uvmaero/SEED/BMS1/report.txt

Info: Processing symbol 'B1:AERO_Footprints:VTC-6'.
Info: Processing symbol 'B2:AERO_Footprints:VTC-6'.
Info: Processing symbol 'B3:AERO_Footprints:VTC-6'.
Info: Processing symbol 'B4:AERO_Footprints:VTC-6'.
Info: Processing symbol 'B5:AERO_Footprints:VTC-6'.
Info: Processing symbol 'B6:AERO_Footprints:VTC-6'.
Info: Processing symbol 'C24:Capacitor_SMD:C_0603_1608Metric_Pad1.08x0.95mm_HandSolder'.
Info: Processing symbol 'C40:'.
Info: Processing symbol 'B7:AERO_Footprints:VTC-6'.
Info: Processing symbol 'R36:Resistor_SMD:R_2512_6332Metric_Pad1.40x3.35mm_HandSolder'.
Info: Processing symbol 'C5:Capacitor_SMD:C_0603_1608Metric_Pad1.08x0.95mm_HandSolder'.
Info: Processing symbol 'C41:Capacitor_SMD:C_0603_1608Metric_Pad1.08x0.95mm_HandSolder'.
Info: Processing symbol 'C25:Capacitor_SMD:C_0603_1608Metric_Pad1.08x0.95mm_HandSolder'.
Info: Processing symbol 'B8:AERO_Footprints:VTC-6'.
Info: Processing symbol 'R33:Resistor_SMD:R_2512_6332Metric_Pad1.40x3.35mm_HandSolder'.
Info: Processing symbol 'J3:Connector_JST:JST_XH_B2B-XH-A_1x02_P2.50mm_Vertical'.
Info: Processing symbol 'C6:Capacitor_SMD:C_0603_1608Metric_Pad1.08x0.95mm_HandSolder'.
Info: Processing symbol 'R11:Resistor_SMD:R_0603_1608Metric_Pad0.98x0.95mm_HandSolder'.
Info: Processing symbol 'B9:AERO_Footprints:VTC-6'.
Info: Processing symbol 'C26:Capacitor_SMD:C_0603_1608Metric_Pad1.08x0.95mm_HandSolder'.
Info: Processing symbol 'R4:Resistor_SMD:R_0603_1608Metric_Pad0.98x0.95mm_HandSolder'.
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
Changed C28 value from 15u to .1u.
Updated C28 fields.
Updated C28 footprint filters to 'C_*'.
Changed C29 value from 15u to .1u.
Updated C29 fields.
Updated C29 footprint filters to 'C_*'.
Changed C30 value from 15u to .1u.
Updated C30 fields.
Updated C30 footprint filters to 'C_*'.
Changed C31 value from 15u to .1u.
Updated C31 fields.
Updated C31 footprint filters to 'C_*'.
Changed C32 value from 15u to .1u.
Updated C32 fields.
Updated C32 footprint filters to 'C_*'.
Changed C33 value from 15u to .1u.
Updated C33 fields.
Updated C33 footprint filters to 'C_*'.
Changed C34 value from 15u to .1u.
Updated C34 fields.
Updated C34 footprint filters to 'C_*'.
Changed C35 value from 15u to .1u.
Updated C35 fields.
Updated C35 footprint filters to 'C_*'.
Changed C36 value from 15u to 0.1u.
Updated C36 fields.
Updated C36 footprint filters to 'C_*'.
Changed C37 value from 15u to .1u.
Updated C37 fields.
Updated C37 footprint filters to 'C_*'.
Changed C38 value from 15u to .1u.
Updated C38 fields.
Updated C38 footprint filters to 'C_*'.
Changed C39 value from 15u to .1u.
Updated C39 fields.
Updated C39 footprint filters to 'C_*'.
Added C41 (footprint 'Capacitor_SMD:C_0603_1608Metric_Pad1.08x0.95mm_HandSolder').
Changed REF** reference designator to C41.
Changed C41 value from C_0603_1608Metric_Pad1.08x0.95mm_HandSolder to 1uf.
Updated C41 symbol association from  to /a6e080b4-c958-4e11-8509-e7d845006a0a.
Updated C41 sheetname to 'Root'.
Updated C41 sheetfile to 'BMS1.kicad_sch'.
Updated C41 footprint filters to 'C_*'.
Add net Net-(U9-VREF2).
Connected C41 pin 2 to Net-(U9-VREF2).
Connected C41 pin 1 to GND2.
Added C42 (footprint 'Capacitor_SMD:C_0603_1608Metric_Pad1.08x0.95mm_HandSolder').
Changed REF** reference designator to C42.
Changed C42 value from C_0603_1608Metric_Pad1.08x0.95mm_HandSolder to 1uf.
Updated C42 symbol association from  to /daf656fa-d1d1-4473-b492-9234140c10e1.
Updated C42 sheetname to 'Root'.
Updated C42 sheetfile to 'BMS1.kicad_sch'.
Updated C42 footprint filters to 'C_*'.
Connected C42 pin 2 to VD.
Connected C42 pin 1 to GND1.
Added C43 (footprint 'Capacitor_SMD:C_0603_1608Metric_Pad1.08x0.95mm_HandSolder').
Changed REF** reference designator to C43.
Changed C43 value from C_0603_1608Metric_Pad1.08x0.95mm_HandSolder to 1uf.
Updated C43 symbol association from  to /74a538cc-4349-4e3c-b11e-23ffc7b8507e.
Updated C43 sheetname to 'Root'.
Updated C43 sheetfile to 'BMS1.kicad_sch'.
Updated C43 footprint filters to 'C_*'.
Connected C43 pin 1 to GND2.
Connected C43 pin 2 to VDD.
Updated D1 fields.
Updated D1 sheetname to 'Root'.
Updated D1 footprint filters to 'LED* LED_SMD:* LED_THT:*'.
Updated D2 fields.
Updated D2 sheetname to 'Root'.
Updated D2 footprint filters to 'LED* LED_SMD:* LED_THT:*'.
Updated J1 fields.
Updated J1 sheetname to 'Root'.
Updated J1 footprint filters to 'Connector*:*_1x??_*'.
Updated J2 fields.
Updated J2 sheetname to 'Root'.
Updated J2 footprint filters to 'Connector*:*_1x??_*'.
Updated J3 fields.
Updated J3 sheetname to 'Root'.
Updated J3 footprint filters to 'Connector*:*_1x??_*'.
Added JP1 (footprint 'Jumper:SolderJumper-3_P1.3mm_Bridged12_RoundedPad1.0x1.5mm_NumberLabels').
Changed REF** reference designator to JP1.
Changed JP1 value from SolderJumper-3_P1.3mm_Bridged12_RoundedPad1.0x1.5mm_NumberLabels to Jumper_3_Bridged12.
Updated JP1 symbol association from  to /2f43baf8-2883-41e4-9e19-3010642f43dc.
Updated JP1 sheetname to 'Root'.
Updated JP1 sheetfile to 'BMS1.kicad_sch'.
Updated JP1 footprint filters to 'Jumper* TestPoint*3Pads* TestPoint*Bridge*'.
Removed JP1 'exclude from BOM' fabrication attribute.
Add net unconnected-(JP1-C-Pad2).
Connected JP1 pin 2 to unconnected-(JP1-C-Pad2).
Add net unconnected-(JP1-A-Pad1).
Connected JP1 pin 1 to unconnected-(JP1-A-Pad1).
Add net unconnected-(JP1-B-Pad3).
Connected JP1 pin 3 to unconnected-(JP1-B-Pad3).
Changed Q2 value from Q_NPN_BCE to DXT5551P5-13_DIO.
Updated Q2 fields.
Updated Q2 sheetname to 'Root'.
Reconnected Q2 pin 1 from Net-(Q2-B) to VCC.
Reconnected Q2 pin 2 from VCC to Net-(Q2-B).
Updated R1 fields.
Updated R1 sheetname to 'Root'.
Updated R1 footprint filters to 'R_*'.
Updated R2 fields.
Updated R2 sheetname to 'Root'.
Updated R2 footprint filters to 'R_*'.
Updated R3 sheetname to 'Root'.
Updated R3 footprint filters to 'R_*'.
Reconnected R3 pin 2 from /SCL2 to /SDA2.
Updated R4 fields.
Updated R4 sheetname to 'Root'.
Updated R4 footprint filters to 'R_*'.
Reconnected R4 pin 2 from /SDA2 to /SCL2.
Updated R5 fields.
Updated R5 sheetname to 'Root'.
Updated R5 footprint filters to 'R_*'.
Updated R6 fields.
Updated R6 sheetname to 'Root'.
Updated R6 footprint filters to 'R_*'.
Updated R7 fields.
Updated R7 sheetname to 'Root'.
Updated R7 footprint filters to 'R_*'.
Updated R8 fields.
Updated R8 sheetname to 'Root'.
Updated R8 footprint filters to 'R_*'.
Updated R9 fields.
Updated R9 sheetname to 'Root'.
Updated R9 footprint filters to 'R_*'.
Updated R10 fields.
Updated R10 sheetname to 'Root'.
Updated R10 footprint filters to 'R_*'.
Updated R11 fields.
Updated R11 sheetname to 'Root'.
Updated R11 footprint filters to 'R_*'.
Updated R12 fields.
Updated R12 sheetname to 'Root'.
Updated R12 footprint filters to 'R_*'.
Updated R13 fields.
Updated R13 footprint filters to 'R_*'.
Add net /BatteryBus1.C15.
Reconnected R13 pin 1 from /BatteryBus1.C14 to /BatteryBus1.C15.
Updated R14 fields.
Updated R14 footprint filters to 'R_*'.
Updated R15 fields.
Updated R15 footprint filters to 'R_*'.
Reconnected R15 pin 1 from Net-(B8--) to Net-(B9-+).
Updated R16 fields.
Updated R16 footprint filters to 'R_*'.
Reconnected R16 pin 1 from Net-(B11--) to Net-(B12-+).
Updated R17 fields.
Updated R17 footprint filters to 'R_*'.
Updated R18 fields.
Updated R18 footprint filters to 'R_*'.
Updated R19 fields.
Updated R19 footprint filters to 'R_*'.
Reconnected R19 pin 1 from Net-(B10--) to Net-(B11-+).
Updated R20 fields.
Updated R20 footprint filters to 'R_*'.
Updated R21 fields.
Updated R21 footprint filters to 'R_*'.
Reconnected R21 pin 1 from Net-(B7--) to Net-(B8-+).
Updated R22 fields.
Updated R22 footprint filters to 'R_*'.
Updated R23 fields.
Updated R23 footprint filters to 'R_*'.
Updated R24 fields.
Updated R24 footprint filters to 'R_*'.
Updated R25 fields.
Updated R25 footprint filters to 'R_*'.
Updated R26 fields.
Updated R26 footprint filters to 'R_*'.
Reconnected R26 pin 1 from Net-(B6--) to Net-(B7-+).
Updated R27 fields.
Updated R27 footprint filters to 'R_*'.
Updated R28 fields.
Updated R28 footprint filters to 'R_*'.
Reconnected R28 pin 1 from Net-(B8--) to Net-(B9-+).
Updated R29 fields.
Updated R29 footprint filters to 'R_*'.
Reconnected R29 pin 1 from Net-(B11--) to Net-(B12-+).
Updated R30 fields.
Updated R30 footprint filters to 'R_*'.
Updated R31 fields.
Updated R31 footprint filters to 'R_*'.
Reconnected R31 pin 1 from Net-(B7--) to Net-(B8-+).
Updated R32 fields.
Updated R32 footprint filters to 'R_*'.
Updated R33 fields.
Updated R33 footprint filters to 'R_*'.
Updated R3 fields.
Updated R34 fields.
Updated R34 footprint filters to 'R_*'.
Updated R35 fields.
Updated R35 footprint filters to 'R_*'.
Reconnected R35 pin 1 from Net-(B10--) to Net-(B11-+).
Updated R36 fields.
Updated R36 footprint filters to 'R_*'.
Add net unconnected-(B6---Pad2).
Updated R37 fields.
Updated R37 footprint filters to 'R_*'.
Reconnected B6 pin 2 from Net-(B6--) to unconnected-(B6---Pad2).
Updated R38 fields.
Updated R38 footprint filters to 'R_*'.
Reconnected R38 pin 1 from Net-(B6--) to Net-(B7-+).
Add net unconnected-(B7---Pad2).
Updated R39 fields.
Updated R39 footprint filters to 'R_*'.
Reconnected B7 pin 2 from Net-(B7--) to unconnected-(B7---Pad2).
Updated R40 fields.
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
Updated R95 fields.
Updated R95 sheetname to 'Root'.
Updated R95 footprint filters to 'R_*'.
Reconnected B22 pin 1 from Net-(B21--) to Net-(B22-+).
Add net unconnected-(B23---Pad2).
Reconnected B23 pin 2 from Net-(B23--) to unconnected-(B23---Pad2).
Updated T1 fields.
Updated T1 sheetname to 'Root'.
Updated T1 footprint filters to 'SOIC4_CBM4D19_SUM SOIC4_CBM4D19_SUM-M SOIC4_CBM4D19_SUM-L'.
Add net Net-(B23-+).
Updated U1 fields.
Updated U1 sheetname to 'Root'.
Updated U1 footprint filters to 'TSSOP*4.4x5mm*P0.65mm*'.
Reconnected B23 pin 1 from Net-(B22--) to Net-(B23-+).
Updated U2 fields.
Updated U2 sheetname to 'Root'.
Updated U2 footprint filters to 'TSSOP*4.4x5mm*P0.65mm*'.
Add net Net-(B24-+).
Updated U3 fields.
Updated U3 sheetname to 'Root'.
Updated U3 footprint filters to 'TSSOP*4.4x5mm*P0.65mm*'.
Reconnected B24 pin 1 from Net-(B23--) to Net-(B24-+).
Updated U4 fields.
Updated U4 sheetname to 'Root'.
Updated U4 footprint filters to 'TSSOP*4.4x5mm*P0.65mm*'.
Add net unconnected-(B24---Pad2).
Updated U5 fields.
Updated U5 sheetname to 'Root'.
Updated U5 footprint filters to 'TSSOP*4.4x5mm*P0.65mm*'.
Reconnected B24 pin 2 from Net-(B24--) to unconnected-(B24---Pad2).
Updated U6 fields.
Updated U6 sheetname to 'Root'.
Updated U6 footprint filters to 'TSSOP*4.4x5mm*P0.65mm*'.
Add net Net-(B25-+).
Updated U7 fields.
Updated U7 sheetname to 'Root'.
Updated U7 footprint filters to 'TSSOP*4.4x5mm*P0.65mm*'.
Reconnected B25 pin 1 from Net-(B24--) to Net-(B25-+).
Updated U8 fields.
Updated U8 sheetname to 'Root'.
Updated U8 footprint filters to 'TSSOP*4.4x5mm*P0.65mm*'.
Changed C1 value from 15u to 0.1uF.
Updated U9 sheetname to 'Root'.
Add net unconnected-(U9-GPIO3-Pad41).
Reconnected U9 pin 41 from /SCL2 to unconnected-(U9-GPIO3-Pad41).
Reconnected U9 pin 12 from Net-(U9-C11) to /BatteryBus1.C11.
Reconnected U9 pin 6 from /BatteryBus1.C14 to /BatteryBus1.C15.
Reconnected U9 pin 28 from Net-(U9-C5) to /BatteryBus1.C5.
Reconnected U9 pin 43 from unconnected-(U9-GPIO5-Pad43) to /SCL2.
Reconnected U9 pin 50 from unconnected-(U9-VREF2-Pad50) to Net-(U9-VREF2).
Reconnected U9 pin 8 from Net-(U9-C13) to /BatteryBus1.C15.
Reconnected U9 pin 38 from Net-(U9-C0) to /BatteryBus1.C0.
Add net Net-(Q3-B).
Reconnected U9 pin 49 from Net-(Q1-B) to Net-(Q3-B).
Reconnected U9 pin 20 from Net-(U9-C8) to /BatteryBus1.C8.
Reconnected U9 pin 24 from Net-(U9-C6) to /BatteryBus1.C6.
Reconnected U9 pin 34 from Net-(U9-C2) to /BatteryBus1.C2.
Reconnected U9 pin 30 from Net-(U9-C4) to /BatteryBus1.C4.
Reconnected U9 pin 10 from Net-(U9-C12) to /BatteryBus1.C12.
Reconnected U9 pin 4 from /BatteryBus1.C14 to /BatteryBus1.C15.
Reconnected U9 pin 22 from Net-(U9-C7) to /BatteryBus1.C7.
Reconnected U9 pin 32 from Net-(U9-C3) to /BatteryBus1.C3.
Reconnected U9 pin 16 from Net-(U9-C10) to /BatteryBus1.C10.
Reconnected U9 pin 36 from Net-(U9-C1) to /BatteryBus1.C1.
Reconnected U9 pin 18 from Net-(U9-C9) to /BatteryBus1.C9.
Updated C1 fields.
Updated U10 sheetname to 'Root'.
Reconnected U10 pin 12 from Net-(U10-C11) to /BatteryBus.C11.
Reconnected U10 pin 24 from Net-(U10-C6) to /BatteryBus.C6.
Reconnected U10 pin 34 from Net-(U10-C2) to /BatteryBus.C2.
Reconnected U10 pin 18 from Net-(U10-C9) to /BatteryBus.C9.
Add net unconnected-(U10-GPIO3-Pad41).
Reconnected U10 pin 41 from /SCL1 to unconnected-(U10-GPIO3-Pad41).
Reconnected U10 pin 36 from Net-(U10-C1) to /BatteryBus.C1.
Reconnected U10 pin 22 from Net-(U10-C7) to /BatteryBus.C7.
Reconnected U10 pin 16 from Net-(U10-C10) to /BatteryBus.C10.
Add net Net-(U10-VREF2).
Reconnected U10 pin 50 from unconnected-(U10-VREF2-Pad50) to Net-(U10-VREF2).
Reconnected U10 pin 8 from Net-(U10-C13) to /BatteryBus.C13.
Reconnected U10 pin 43 from unconnected-(U10-GPIO5-Pad43) to /SCL1.
Reconnected U10 pin 20 from Net-(U10-C8) to /BatteryBus.C8.
Reconnected U10 pin 30 from Net-(U10-C4) to /BatteryBus.C4.
Reconnected U10 pin 32 from Net-(U10-C3) to /BatteryBus.C3.
Reconnected U10 pin 28 from Net-(U10-C5) to /BatteryBus.C5.
Reconnected U10 pin 38 from Net-(U10-C0) to /BatteryBus.C0.
Reconnected U10 pin 10 from Net-(U10-C12) to /BatteryBus.C12.
Reconnected via from Net-(B7--) to Net-(B8-+).
Reconnected via from Net-(B13--) to Net-(B14-+).
Reconnected via from Net-(B15--) to Net-(B16-+).
Reconnected via from Net-(B17--) to Net-(B18-+).
Reconnected via from Net-(B19--) to Net-(B20-+).
Reconnected via from Net-(B21--) to Net-(B22-+).
Reconnected via from Net-(B23--) to Net-(B24-+).
Reconnected copper zone '$teardrop_padvia$' from Net-(U10-C2) to /BatteryBus.C2.
Reconnected copper zone '$teardrop_padvia$' from Net-(U10-C6) to /BatteryBus.C6.
Reconnected copper zone '$teardrop_padvia$' from Net-(U9-C6) to /BatteryBus1.C6.
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
Warning: No net found for component U10 pad 26 (no pin 26 in symbol).
Warning: No net found for component U9 pad 15 (no pin 15 in symbol).
Warning: No net found for component U10 pad 2 (no pin 2 in symbol).
Warning: No net found for component U10 pad 3 (no pin 3 in symbol).
Warning: No net found for component U9 pad 3 (no pin 3 in symbol).
Warning: No net found for component U9 pad 14 (no pin 14 in symbol).
Warning: No net found for component U10 pad 27 (no pin 27 in symbol).
Error: Cannot add R96 (no footprint assigned).
Error: Cannot add Q3 (footprint 'AERO_Footprints:DXT5551P5-13_DIO' not found).
Error: Cannot add R97 (no footprint assigned).
Error: Cannot add C40 (no footprint assigned).

Info: Total warnings: 12, errors: 4.
