uvmaero/SEED/CleanSpeed_6.0_Board-Design (1)/CleanSpeed_6.0_Board-Design/PAC-man reed/digikey.xlsx

Index | Quantity | Part Number | Manufacturer Part Number | Description | Customer Reference | Available | Backorder | Unit Price | Extended Price USD
1 | 3 | 374-1408-5-ND | SHV12-1A85-78D3K | RELAY REED SPST 1A 12V |  | 3 | 0 | 11.29 | 33.87
2 | 2 | 725-S1-12-BDM-ND | S1-12-BDM | RELAY REED 1 N/C 1.5KV 12V |  | 2 | 0 | 29.09 | 58.18
3 | 1000 | 311-15.0KHRCT-ND | RC0603FR-0715KL | RES 15K OHM 1% 1/10W 0603 |  | 1000 | 0 | 0.00532 | 5.32
4 | 15 | 311-.15QCT-ND | RL0603FR-070R15L | RES 0.15 OHM 1% 1/10W 0603 |  | 15 | 0 | 0.125 | 1.88
5 | 3 | 1965-ESP32-S3-DEVKITC-1-N8-ND | ESP32-S3-DEVKITC-1-N8 | ESP32-S3-WROOM-1-N8 DEV BRD |  | 3 | 0 | 15 | 45.00
6 | 10 | B12J2K5E-ND | B12J2K5E | RES 2.5K OHM 5% 12W AXIAL |  | 10 | 0 | 4.52 | 45.20
7 | 8 | 505-ADG728BRUZ-REEL7CT-ND | ADG728BRUZ-REEL7 | IC MUX 8:1 4.5OHM 16TSSOP |  | 8 | 0 | 6.51 | 52.08
8 | 4 | Z2975-ND | G5NB-1A4-E-DC12 | RELAY GEN PURPOSE SPST 5A 12V |  | 4 | 0 | 1.92 | 7.68
9 | 4 | 505-LT1963AEST-3.3#PBF-ND | LT1963AEST-3.3#PBF | IC REG LINEAR 3.3V 1.5A SOT223-3 |  | 4 | 0 | 6.23 | 24.92
10 | 10 | 505-LTC6820HMS#3ZZPBF-ND | LTC6820HMS#3ZZPBF | IC INTERFACE SPECIALIZED 16MSOP |  | 10 | 0 | 7.231 | 72.31
