uvmaero/SEED/BMS1/Jumper/SLPRABPNO/3D/SLPRABPNO.stp

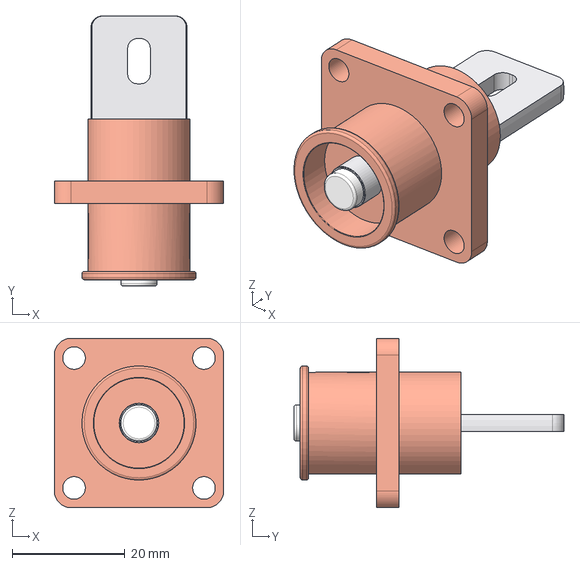
[picture p9: CAD file, 2024-09-30]
BMS1/Jumper/SLPRABPNO/3D/SLPRABPNO.stp
30.0 x 47.8 x 30.0 mm
