uvmaero/SEED/BMS1/Printout.pdf

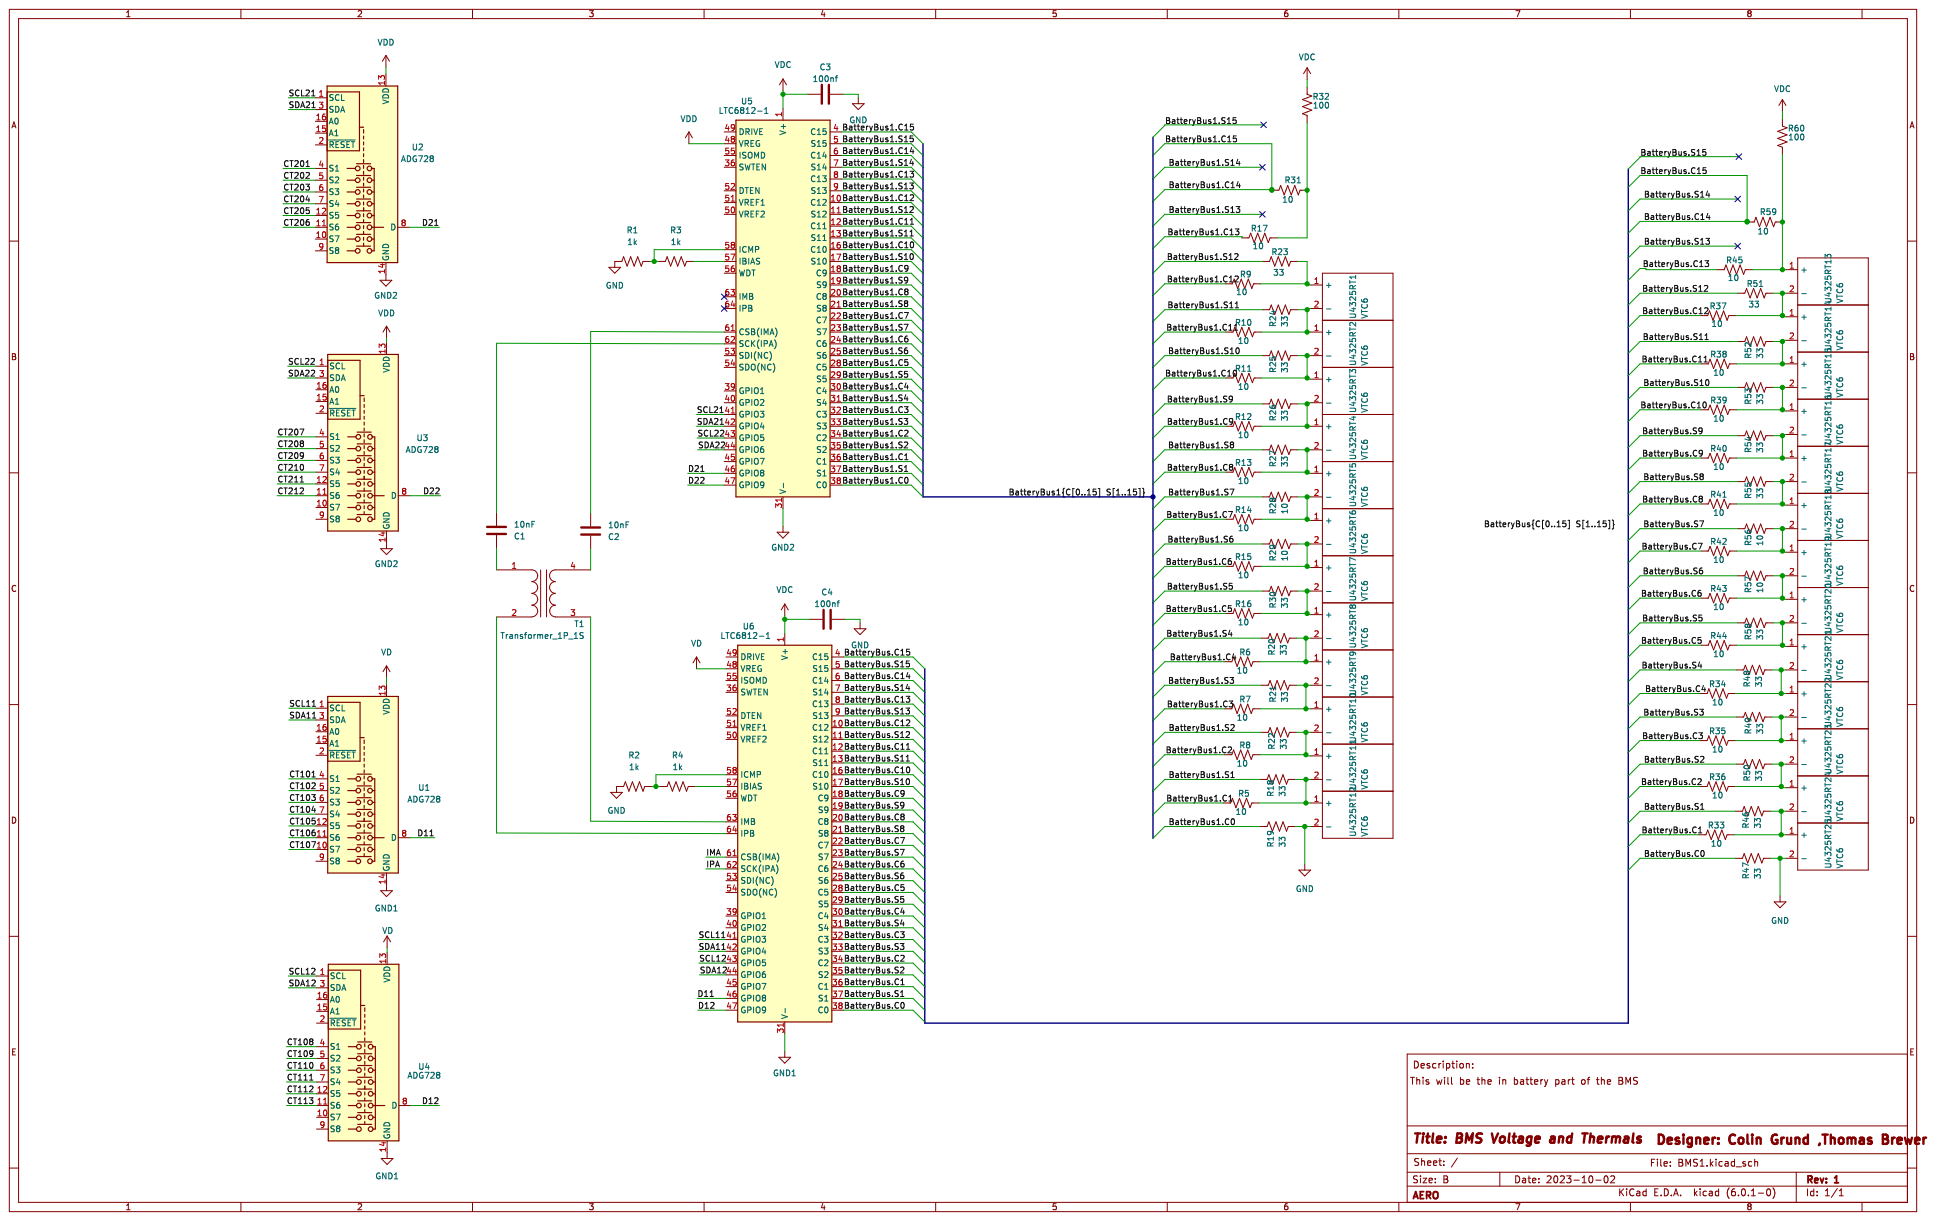
[picture p10: page 1]
