uvmaero/SEED/CleanSpeed_6.0_Board-Design (1)/CleanSpeed_6.0_Board-Design/PAC-man reed/footyb.pdf

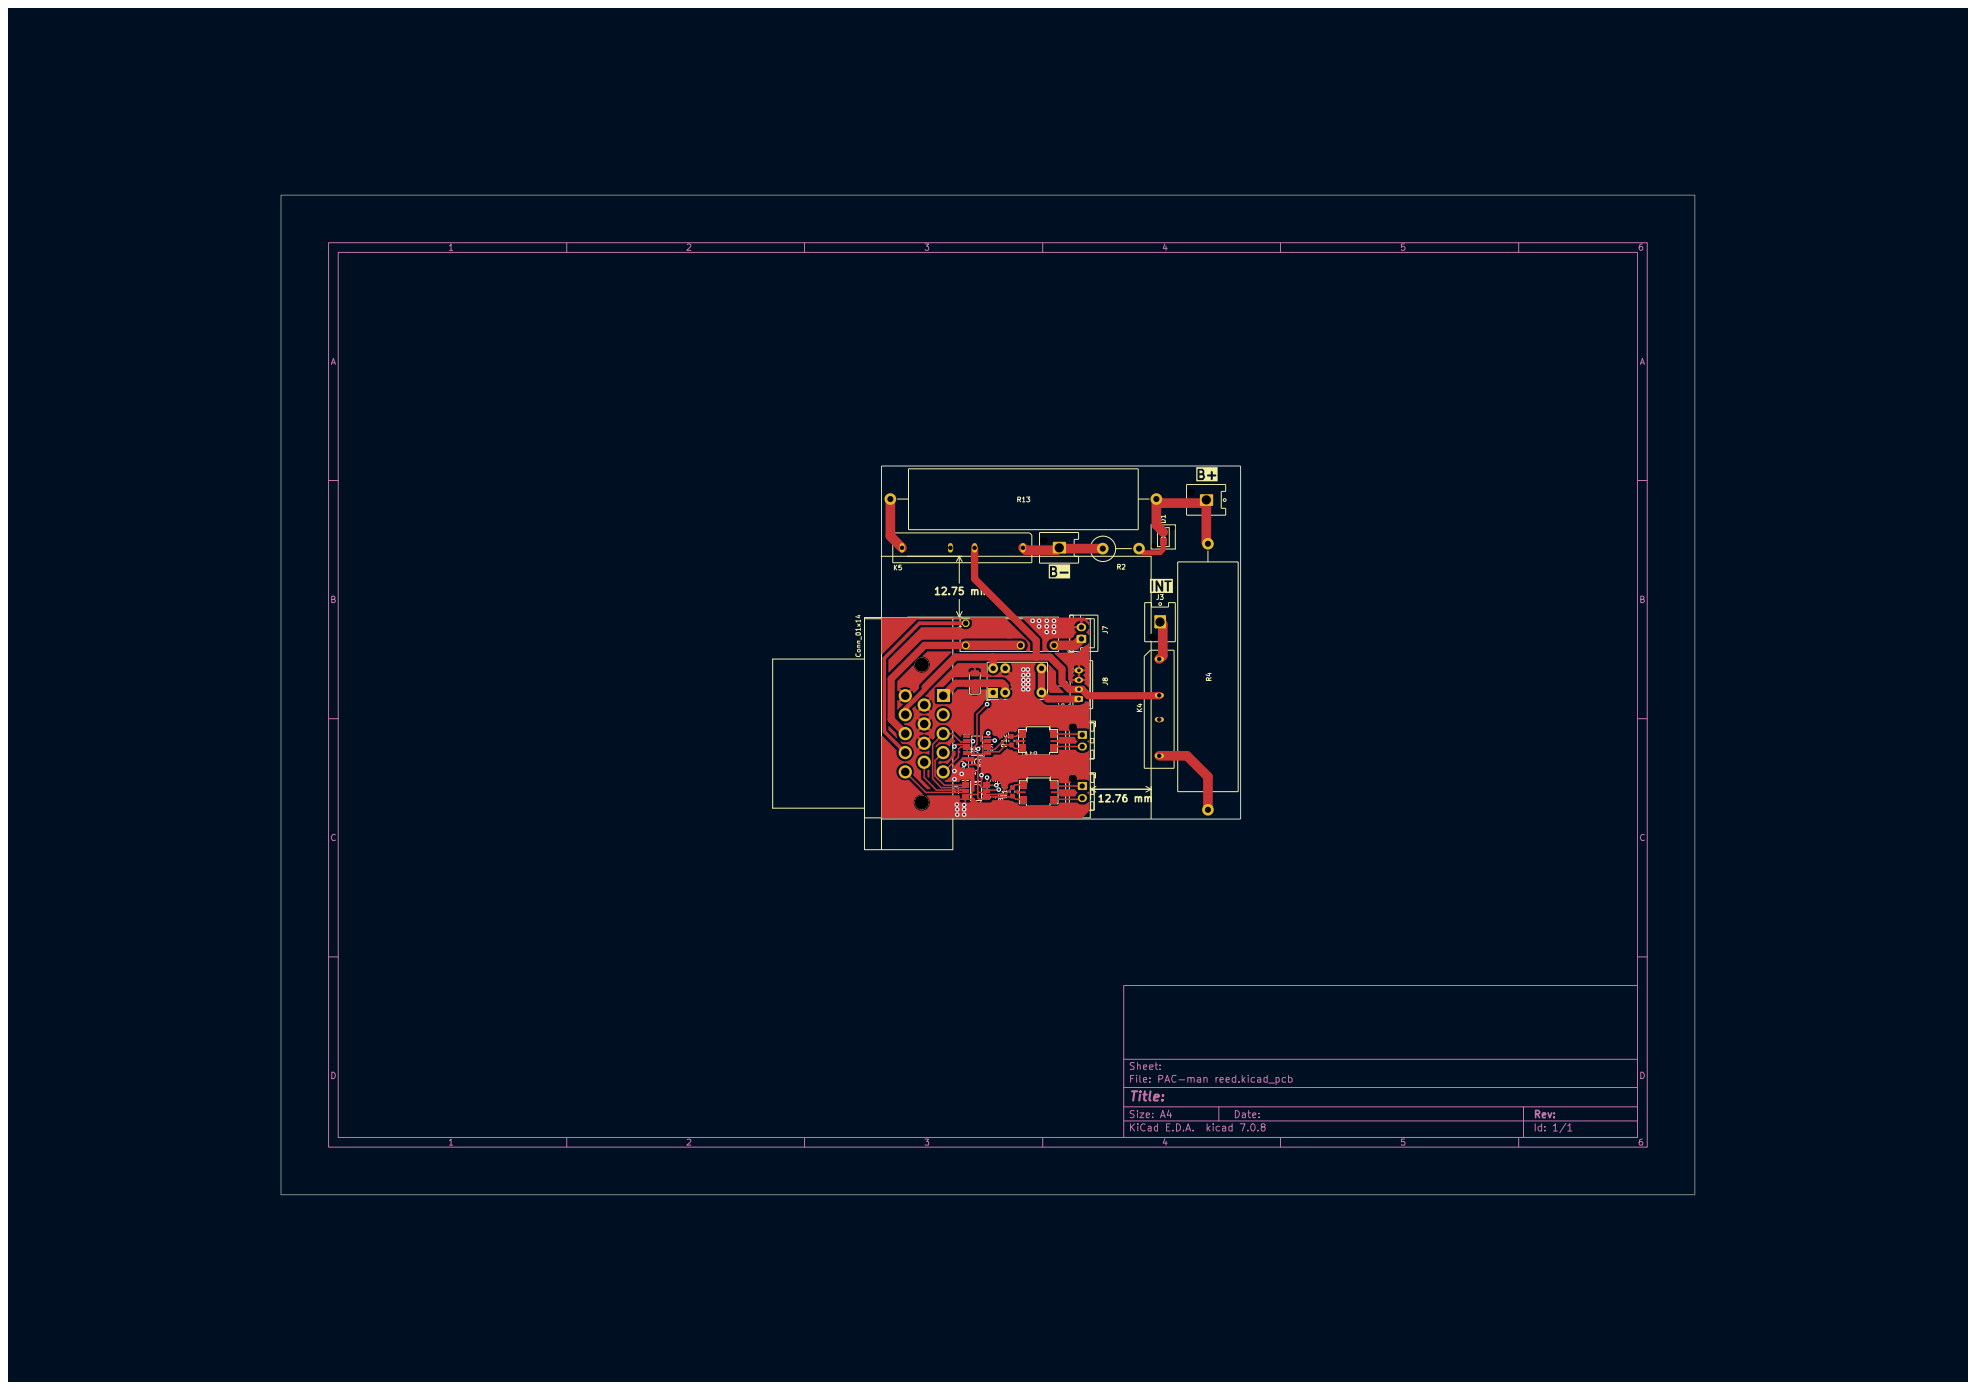
[picture p11: page 1]
