uvmaero/SEED/CleanSpeed_6.0_Board-Design (1)/CleanSpeed_6.0_Board-Design/PAC-man reed/footyf.pdf

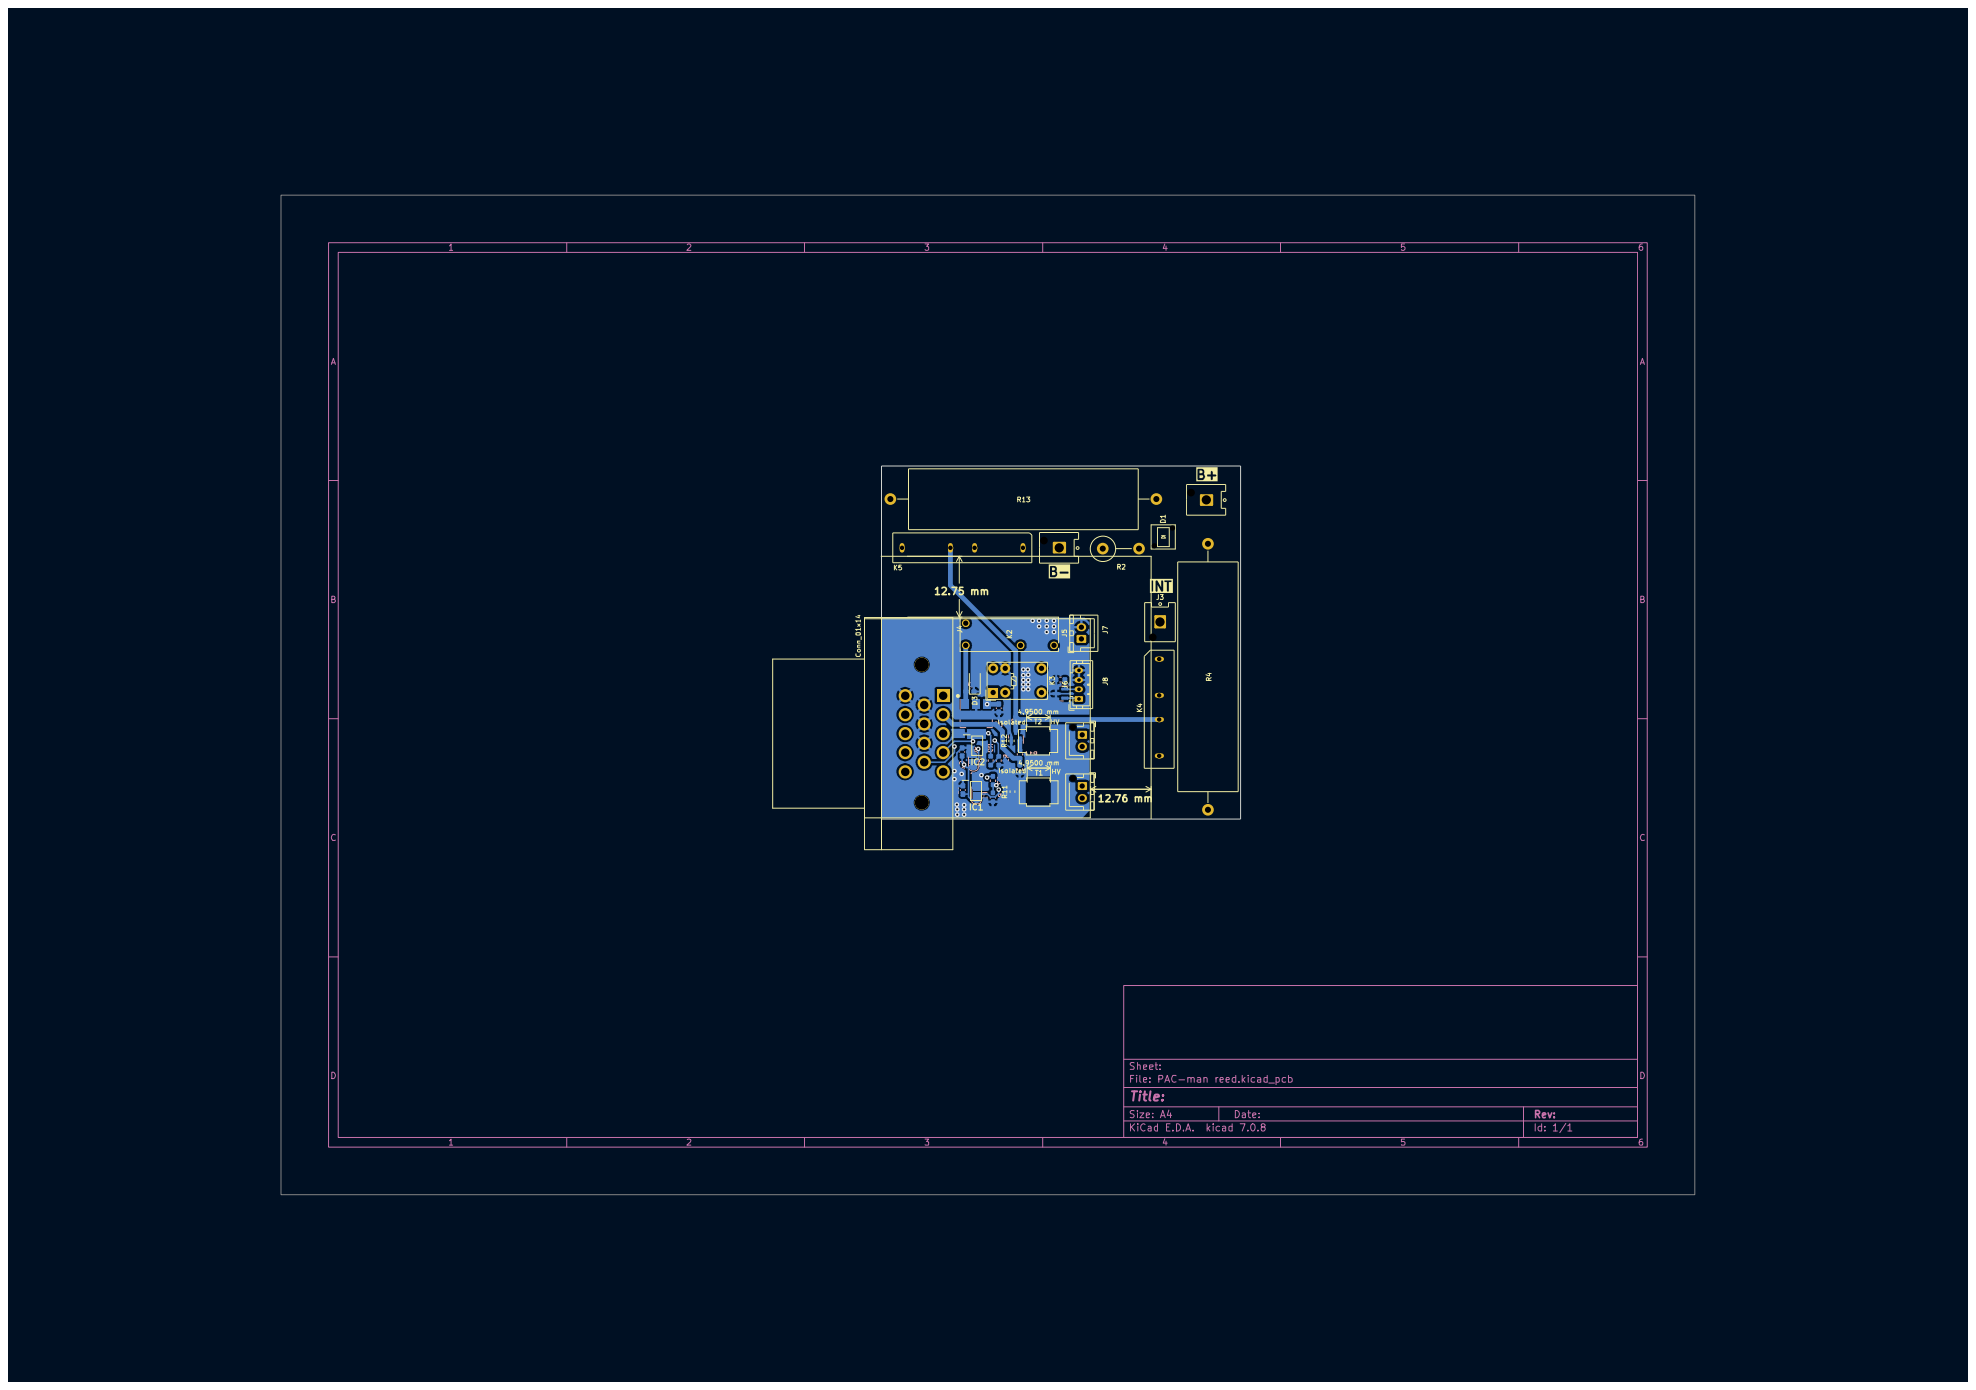
[picture p12: page 1]
