uvmaero/SEED/CleanSpeed_6.0_Board-Design (1)/CleanSpeed_6.0_Board-Design/PAC-man reed/PACMAN.pdf

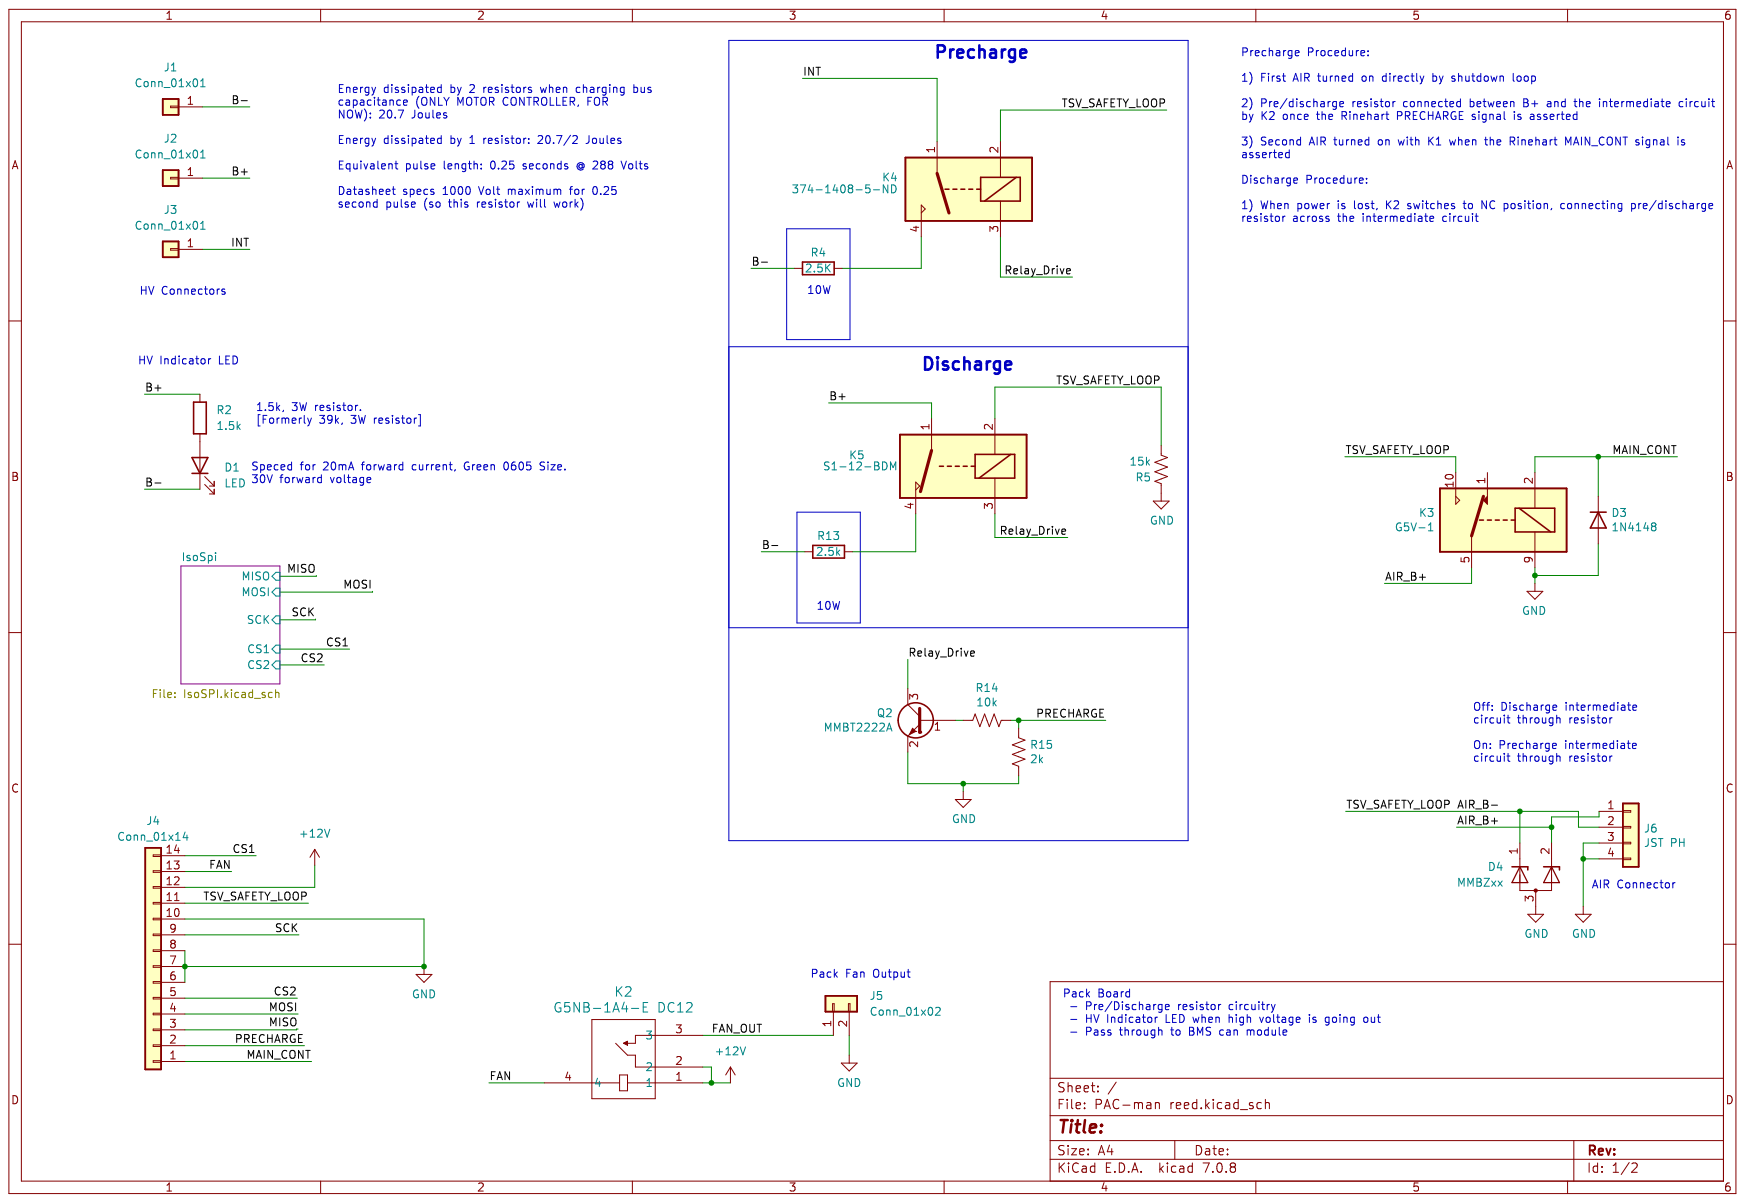
[picture p13: page 1]

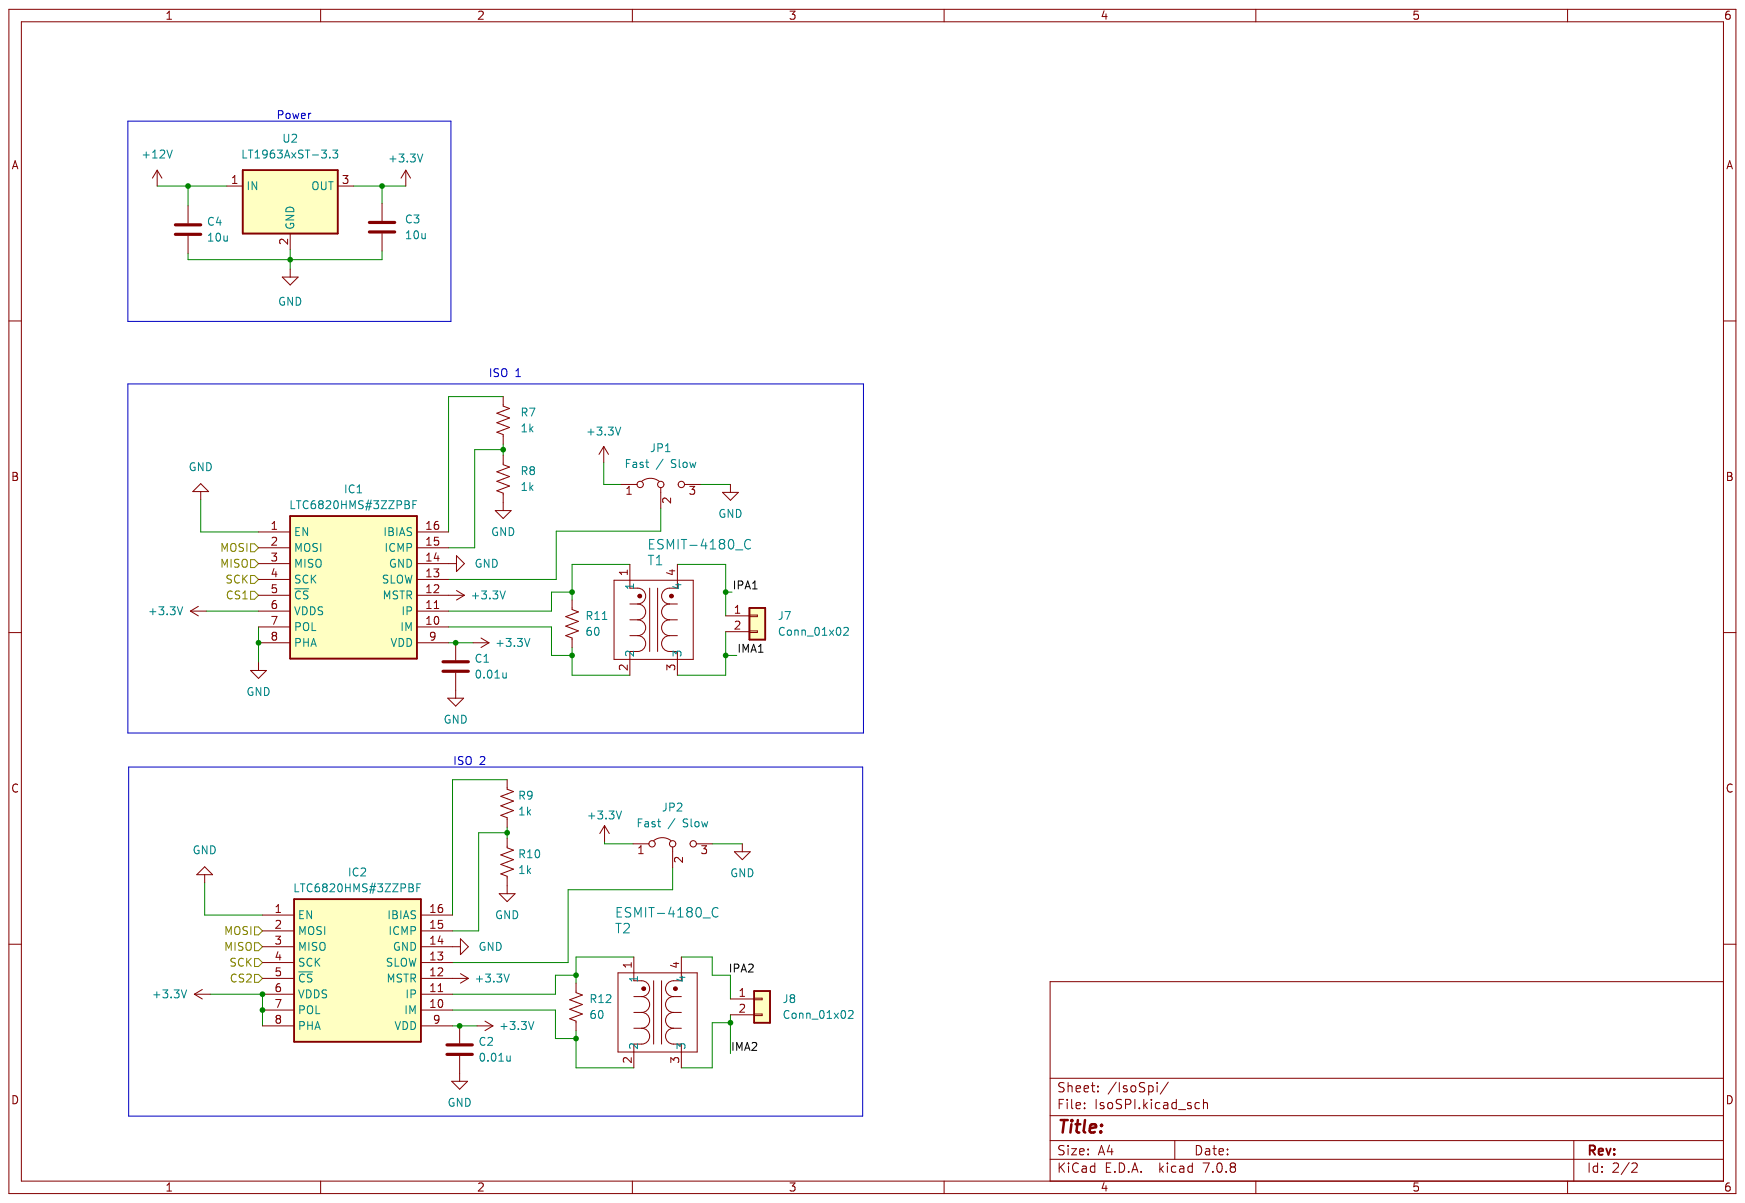
[picture p14: page 2]
