uvmaero/SEED/CleanSpeed_6.0_Board-Design (1)/CleanSpeed_6.0_Board-Design/Documentation/Tractive System/Tractive System.pdf

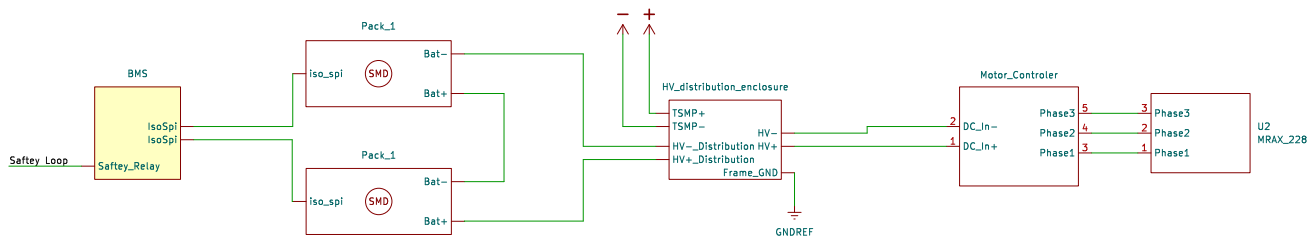
[picture p16: page 1]
