uvmaero/SEED/BMS1/BMS for Presentation.pdf

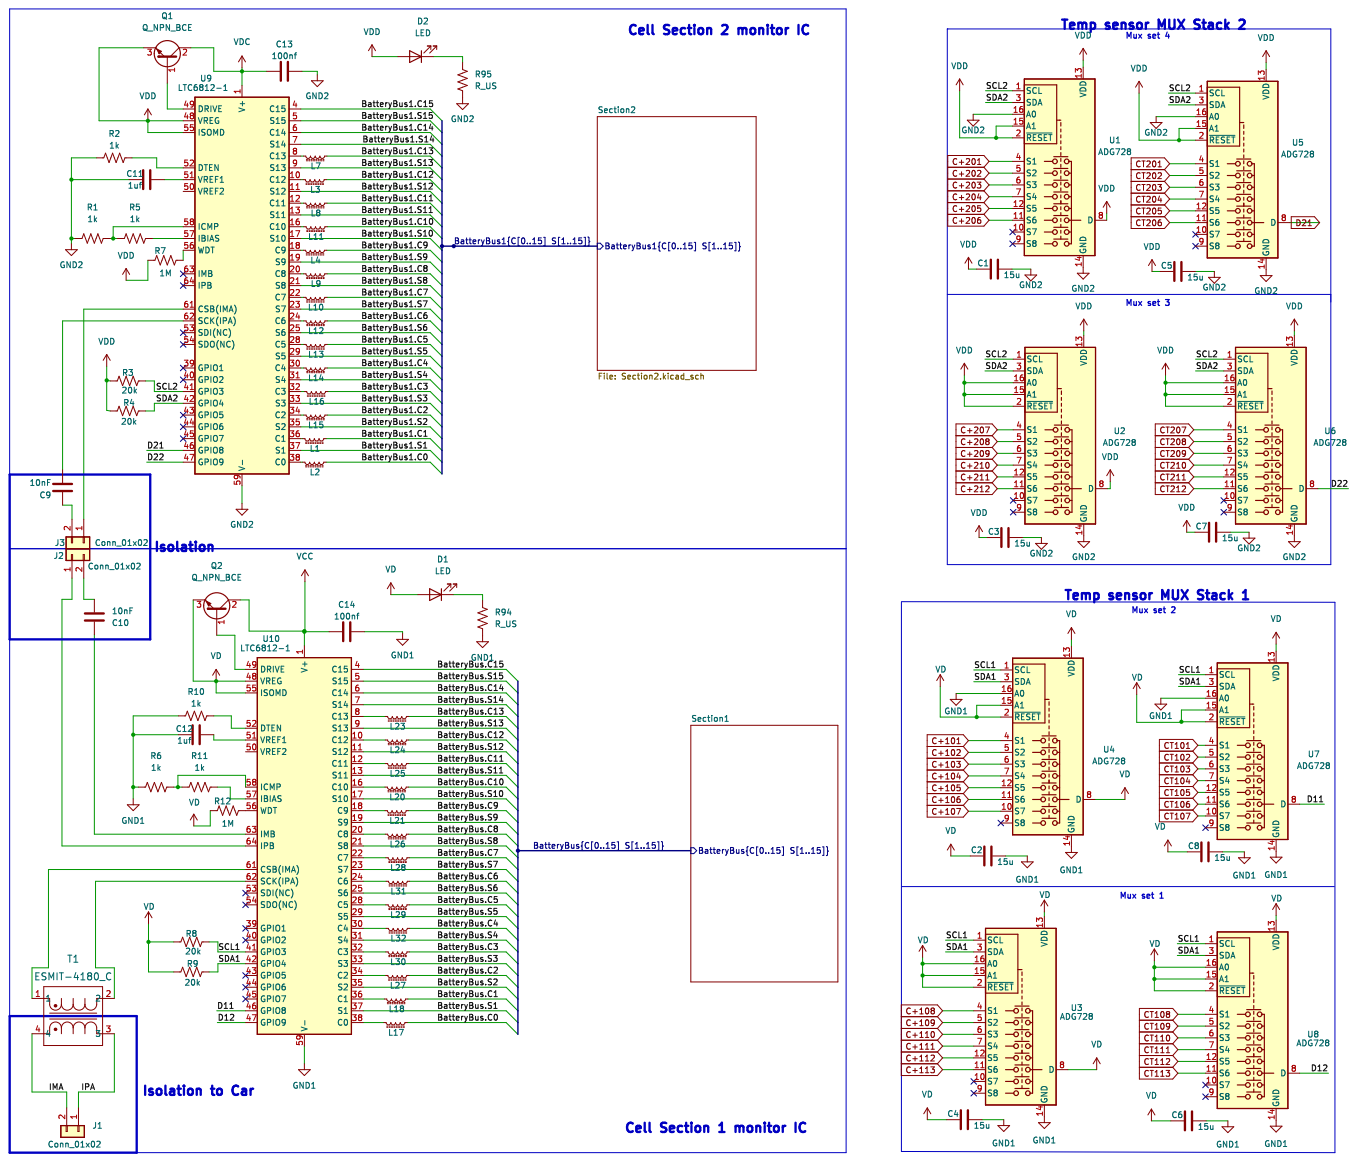
[picture p17: page 1]

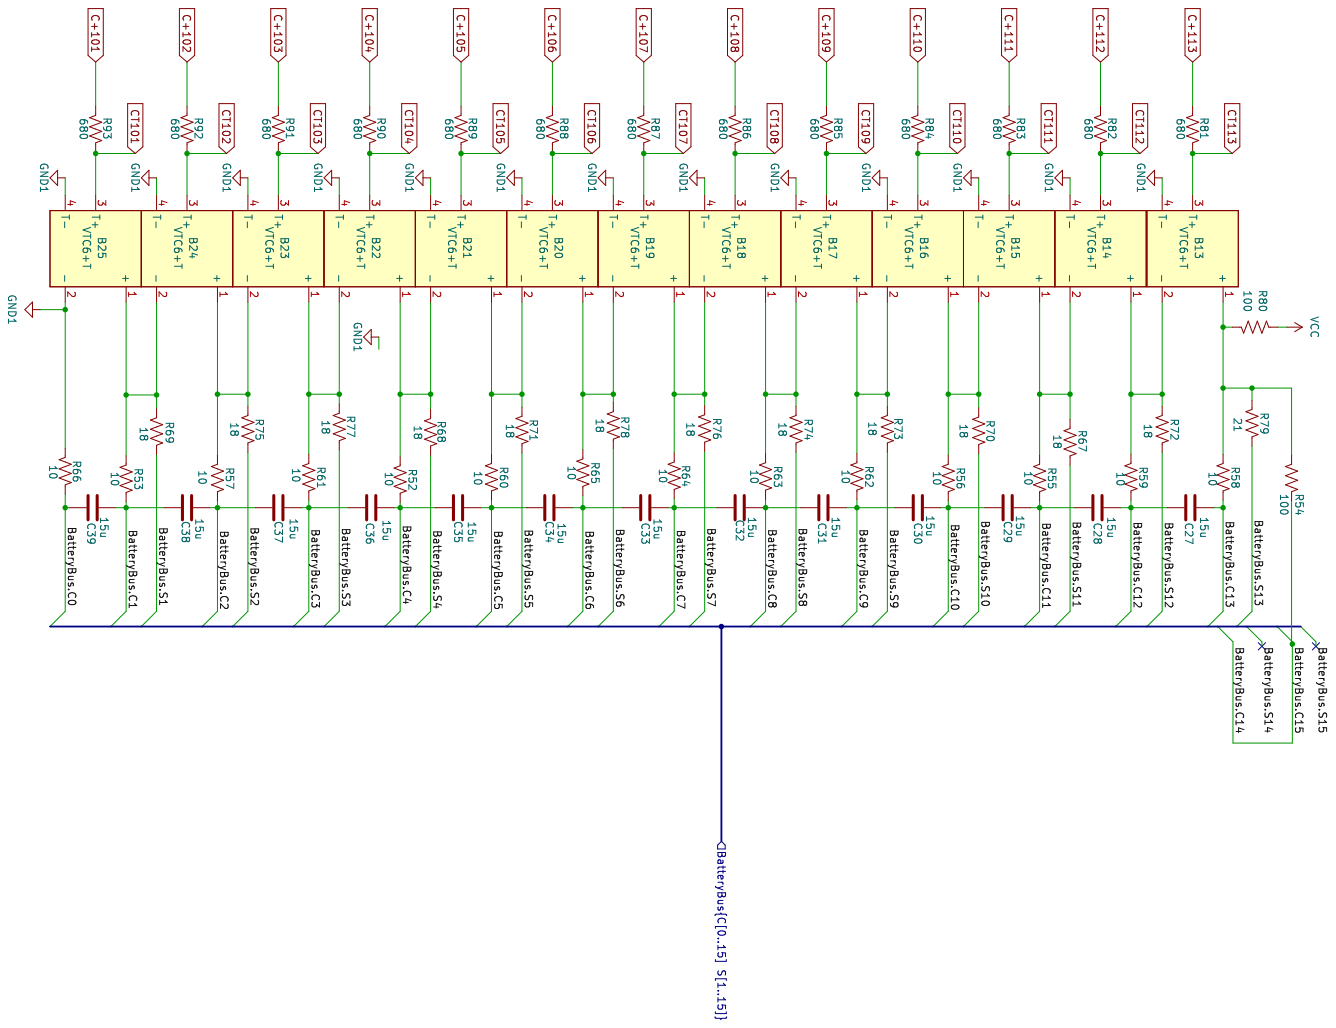
[picture p18: page 2]

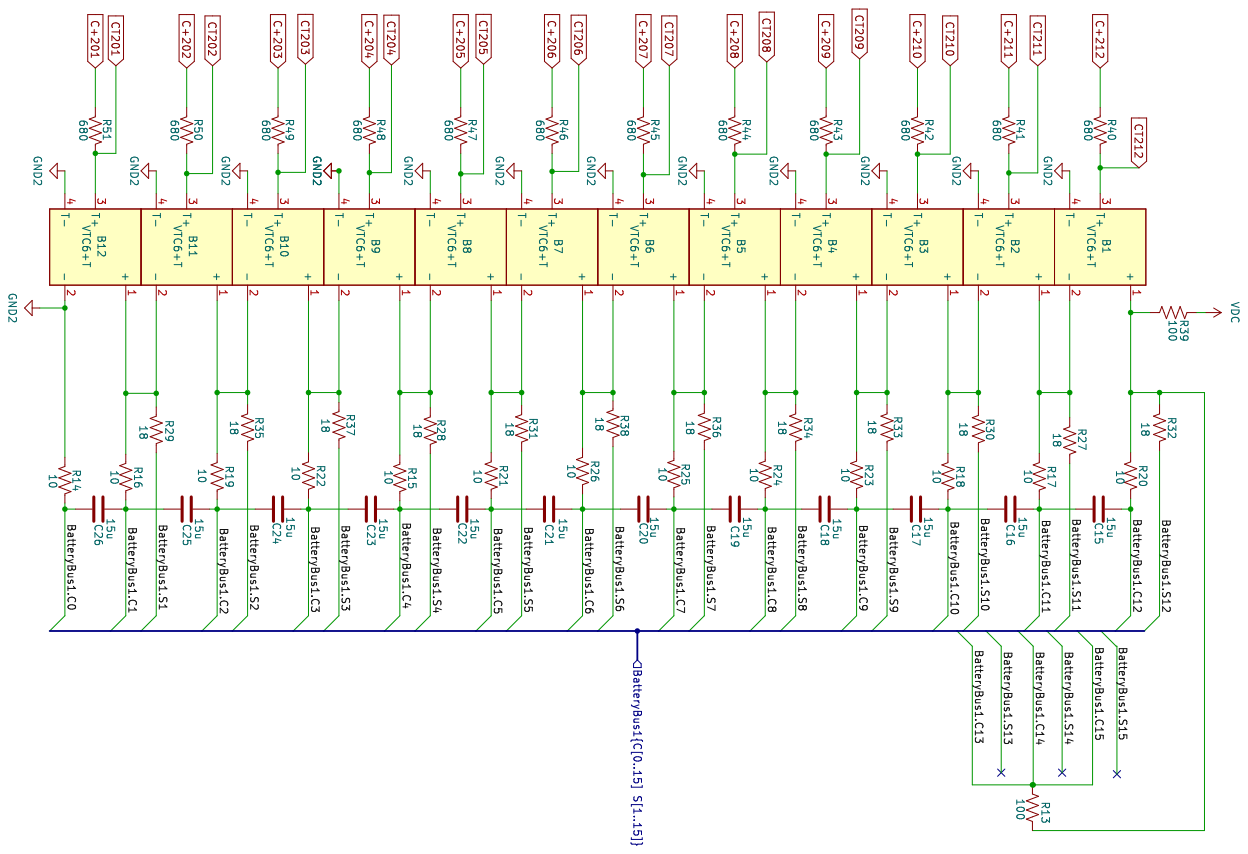
[picture p19: page 3]
