uvmaero/SEED/(list of files, drawings)

Other design files:
BMS1/freerouting.dsn
BMS1/Jumper/freerouting.dsn
BMS1/Jumper/temp-freerouting.dsn
