uvmaero/SEED/(commit log)

2023-10-03 BMS update
    [BMS1.kicad_sch]
2023-10-04 two strings
    [BMS1.kicad_sch]
2023-10-09 sprint 1 push
    [BMS1.kicad_sch]
2023-10-09 Created MainBMS
    [MainBMS.kicad_pcb, MainBMS.kicad_sch]
2023-10-10 BMS rev1
    [BMS1.kicad_pcb, BMS1.kicad_sch]
2023-10-12 start footprint
    [BMS1.kicad_pcb, BMS1.kicad_sch]
2023-10-25 SChematic to sheets
    [BMS1.kicad_pcb, BMS1.kicad_sch, Section1.kicad_sch, Section2.kicad_sch]
2023-10-25 First Iteration of Main Board
2023-10-26 Vias it is
    [BMS1.kicad_pcb, BMS1.step]
2023-10-27 Post Design Review
    [BMS1.kicad_pcb, BMS1.kicad_sch]
2023-11-07 Cap Change
    [BMS1.kicad_pcb, BMS1.kicad_sch, Section1.kicad_sch, Section2.kicad_sch]
2023-11-08 smol made
    [Test Flex.kicad_pcb, Test Flex.kicad_sch, bom.csv, designators.csv, positions.csv]
2023-11-09 Everybody is in their general local!
    [BMS1.kicad_pcb, BMS1.kicad_sch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]
2023-11-10 First PCB Revision
    [MainBMS.kicad_sch]
2023-11-10 Added Code and README file
    [MainBMS.kicad_pcb]
2023-11-19 V1 Layout!
    [BMS1-B_Cu.gbr, BMS1-B_Mask.gbr, BMS1-B_Paste.gbr, BMS1-B_Silkscreen.gbr, BMS1-Edge_Cuts.gbr, BMS1-F_Cu.gbr, BMS1-F_Mask.gbr, BMS1-F_Paste.gbr]
2023-12-31 Schematic (Self) Review Done
    [BMS1-B_Cu.gbr, BMS1-B_Mask.gbr, BMS1-B_Paste.gbr, BMS1-B_Silkscreen.gbr, BMS1-Edge_Cuts.gbr, BMS1-F_Cu.gbr, BMS1-F_Mask.gbr, BMS1-F_Paste.gbr]
2024-02-26 fixed footy
    [BMS1.kicad_pcb_bom.csv, BMS1.kicad_pcb_positions.csv, BMS1.kicad_sch, Jumper.kicad_pcb, Jumper.kicad_sch, bmsstep.kicad_pcb, bmsstep.kicad_sch, bom.csv]
2024-04-18 final before comp
    [BMS1.kicad_sch, SLPRABPNO.stp]
2024-04-19 fixed to whats on board footy not changed
    [BMS1.kicad_sch, Section1.kicad_sch, Section2.kicad_sch]
2024-11-14 Added text
    [Section1.kicad_sch]
2024-11-15 Meeting 11/14/24
    [BMS1.kicad_sch, Section1.kicad_sch, Section2.kicad_sch]
2025-01-30 Deleted cell shorts
    [BMS1.kicad_sch, Section1.kicad_sch, Section2.kicad_sch]
2025-01-30 GPIO pin correction
    [BMS1.kicad_sch]
2025-01-30 added chokes
    [BMS1.kicad_sch, Section2.kicad_sch]
2025-01-31 Changed board creator names
2025-01-31 Changed board name on PCB
2025-02-02 Ran ERC
    [BMS1.kicad_sch]
2025-02-04 BigDaddy Meeting
    [BMS1.kicad_sch, Section1.kicad_sch, Section2.kicad_sch]
2025-02-06 ERC fixes
    [BMS1.kicad_sch, Section1.kicad_sch, Section2.kicad_sch]
2025-02-06 ERC error fixes
    [BMS1.kicad_sch, Section1.kicad_sch, Section2.kicad_sch]
2025-02-07 updated choke symbol and footprint
    [BMS1.kicad_sch]
2025-02-07 rotated chokes and added datasheet info, changed a couple footprints
    [BMS1.kicad_sch]
2025-02-07 updated datasheets and MPNs
    [BMS1.kicad_sch, Section1.kicad_sch, Section2.kicad_sch]
2025-02-09 changed R18ohm footprints
2025-02-13 PCB Routing
    [BMS1.kicad_pcb]
2025-02-23 MOre Routinggggg
    [BMS1.kicad_pcb, BMS1.kicad_sch, Section2.kicad_sch]
2025-02-24 more fucking routing
    [BMS1.kicad_pcb, BMS1.kicad_sch]
2025-02-26 DRC fixes
    [BMS1.kicad_sch]
2025-02-28 DRC error fixes
    [BMS1.kicad_sch, Section1.kicad_sch, Section2.kicad_sch]
2025-02-28 BOM updates
    [BMS1.kicad_sch, Section1.kicad_sch, Section2.kicad_sch]
2025-03-01 HV LV isol dimensions
    [bom.csv, designators.csv, positions.csv]
2025-03-02 Finishing Touches!
    Updated trace widths. Board is ready order. IDK what im gonna do with all this free time now, maybe get my life back?
2025-04-04 updated precharge board
    - added C5, C6 and changed C1 and C2 to 0.1u
    - added 2k pullup resistors to MOSI pins
    - pulled Slow to GND, deleted the switch
    - updated the capacitor and resistor footprints
    -----------we need to remake the PCB. Will need physical dimensions from last board. Also will need to consult p23 of the LTC6820 datasheet for for spacing and ground plane considerations
    [precharge_2025.kicad_pcb, precharge_2025.kicad_sch]
2025-04-04 precharge 2025 update
    updated precharge board
    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
    [IsoSPI.kicad_sch, PAC-man reed.kicad_pcb_bom.csv, PAC-man reed.kicad_pcb_positions.csv, PAC-man reed_2025.kicad_pcb, PAC-man reed_2025.kicad_sch, bom.csv, designators.csv, positions.csv]
2025-04-04 deleted bad folder
    [precharge_2025.kicad_pcb, precharge_2025.kicad_sch]
2025-04-04 updating precharge
    [Accumulator_Container.kicad_sch, IsoSPI.kicad_sch, PAC-man reed.csv, PAC-man reed.kicad_pcb, PAC-man reed.kicad_pcb_bom.csv, PAC-man reed.kicad_pcb_positions.csv, PAC-man reed.kicad_sch, PACman LV.kicad_pcb]
2025-04-04 Pre-charge routing
    [PAC-man reed.kicad_pcb, bom.csv, designators.csv, positions.csv]
